teamnexora-doc/GuardianX/CEP.stl

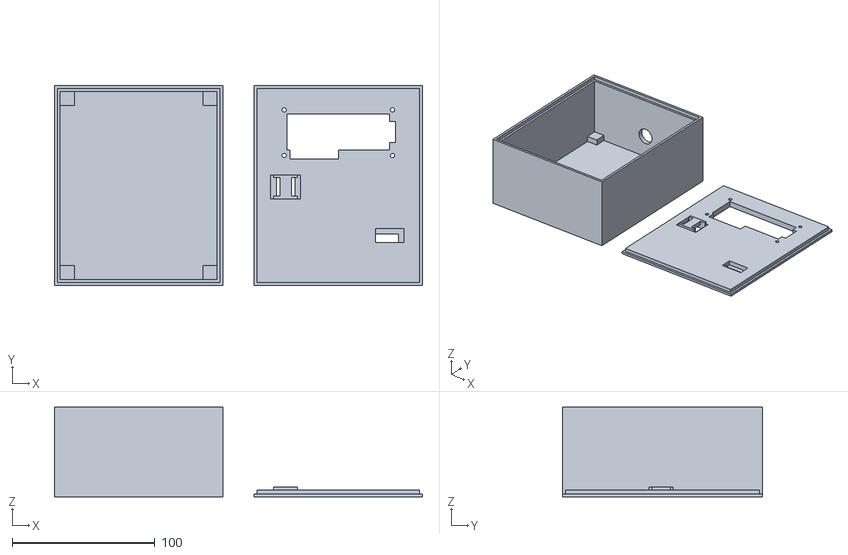
[picture p1: CAD file, 2026-11-05]
CEP.stl
258.0 x 140.0 x 63.0
